MatthiasToberer/Hevo_STL_Archive/Bed_Brackets/Bed_Bracket_20_1.0.stl

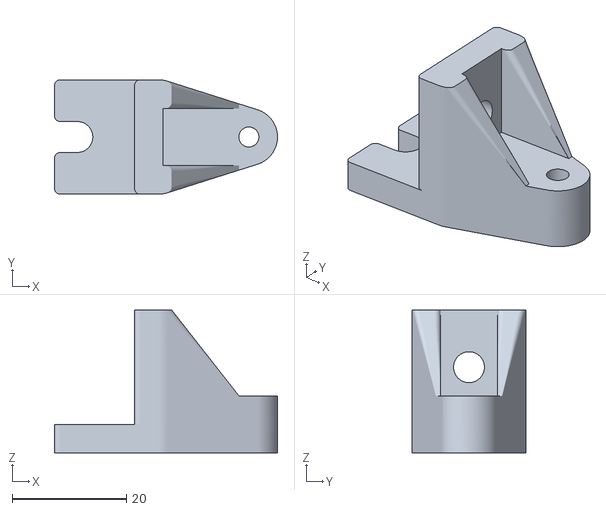
[picture p1: CAD file, 2019-02-11]
Bed_Brackets/Bed_Bracket_20_1.0.stl
39.0 x 20.0 x 25.0
