MatthiasToberer/Hevo_STL_Archive/Idler_Pulley/Idler-PULLEY_L_Y10_V2.0_European.stl

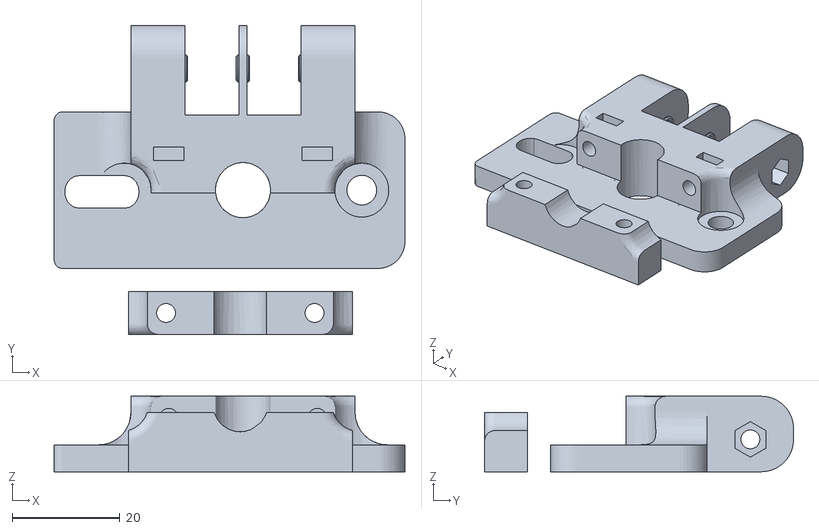
[picture p2: CAD file, 2019-02-11]
Idler_Pulley/Idler-PULLEY_L_Y10_V2.0_European.stl
65.0 x 57.2 x 14.0
