MatthiasToberer/Hevo_STL_Archive/Spindel/TR8x8_Support_BED.stl

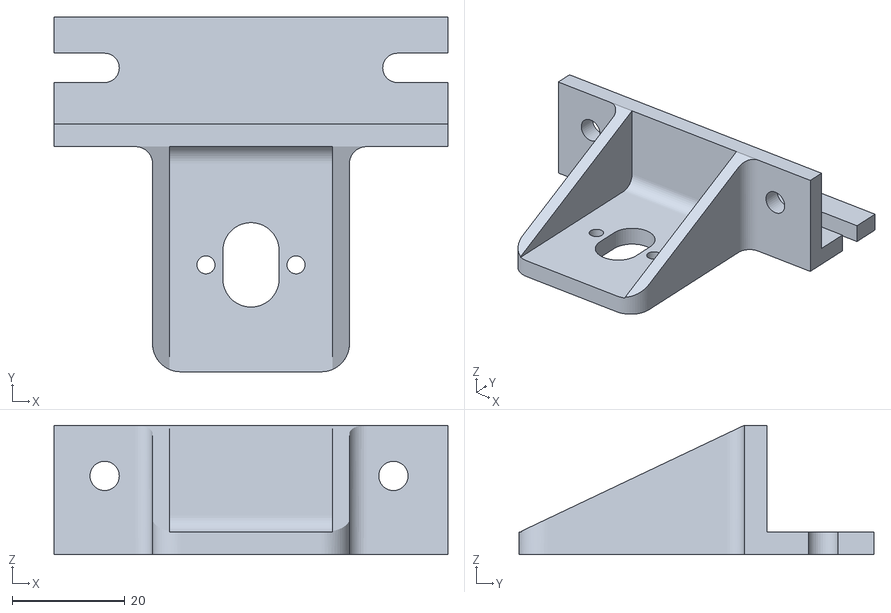
[picture p3: CAD file, 2019-02-11]
Spindel/TR8x8_Support_BED.stl
70.0 x 63.0 x 23.0
