MatthiasToberer/Hevo_STL_Archive/XY/XY_Carriage_Clamp_10mm_Bearing.stl

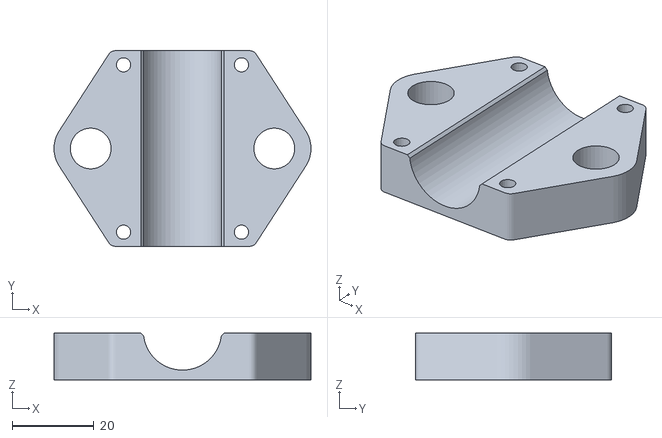
[picture p5: CAD file, 2019-02-11]
XY/XY_Carriage_Clamp_10mm_Bearing.stl
63.0 x 48.0 x 11.5
