MatthiasToberer/Hevo_STL_Archive/Bed_Brackets/Bed_Bracket_Variable_15-30.stl

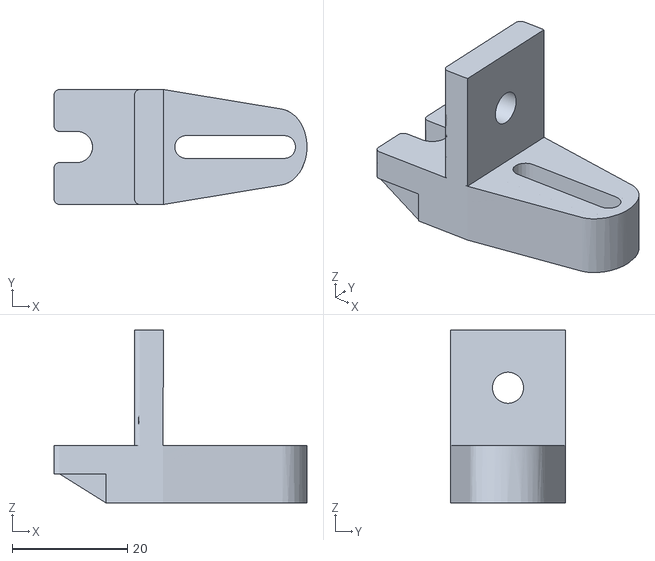
[picture p6: CAD file, 2019-02-11]
Bed_Brackets/Bed_Bracket_Variable_15-30.stl
44.0 x 20.0 x 30.0
