MatthiasToberer/Hevo_STL_Archive/Idler_Pulley/Idler-PULLEY_R_Y10_V2.0_European.stl

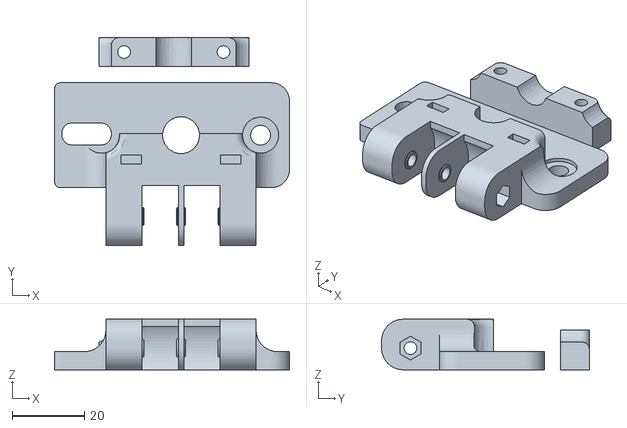
[picture p7: CAD file, 2019-02-11]
Idler_Pulley/Idler-PULLEY_R_Y10_V2.0_European.stl
65.0 x 57.5 x 14.0
