MatthiasToberer/Hevo_STL_Archive/Various_Parts/X_End_Stop_Flag_1.1.STL

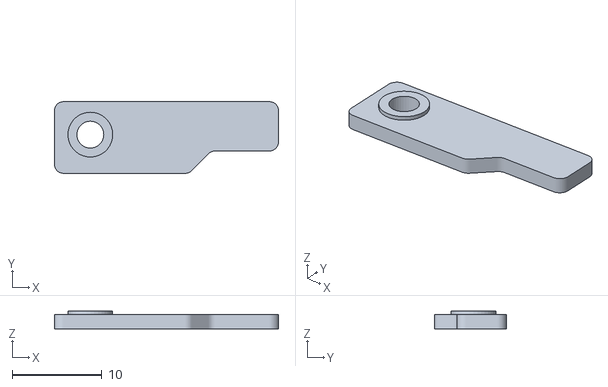
[picture p8: CAD file, 2019-02-11]
Various_Parts/X_End_Stop_Flag_1.1.STL
25.0 x 8.00 x 2.00
