MatthiasToberer/Hevo_STL_Archive/X_Carriage_Hotend/PP_Orion_Heatsink_Mount_Clamp_2.1.STL

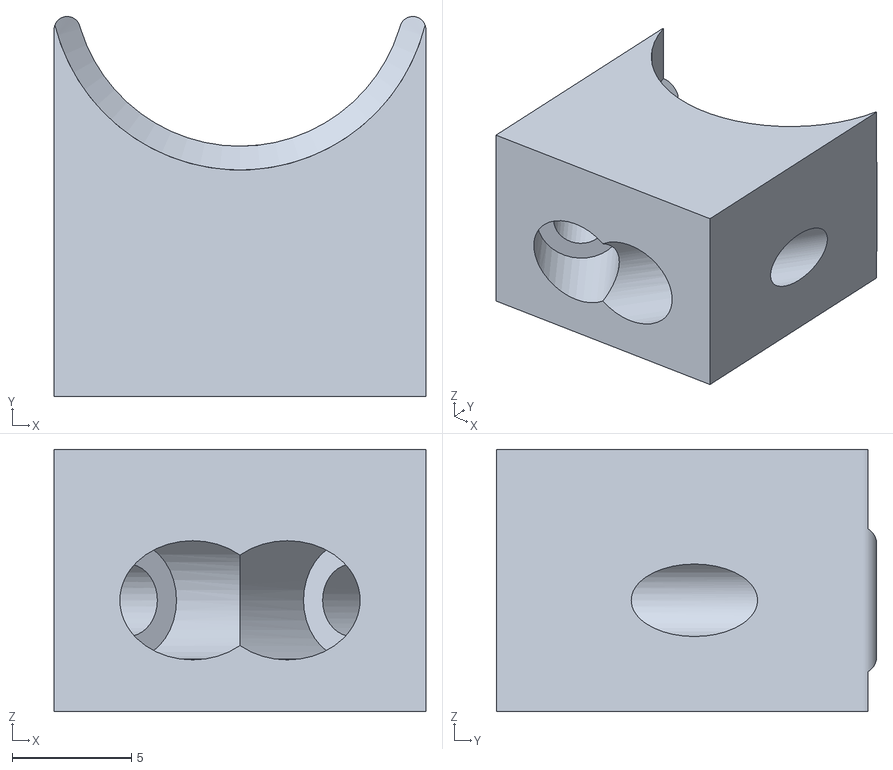
[picture p9: CAD file, 2019-02-11]
X_Carriage_Hotend/PP_Orion_Heatsink_Mount_Clamp_2.1.STL
15.6 x 15.9 x 11.0
