MatthiasToberer/Hevo_STL_Archive/XY/XY_Carriage_HCEvo_X10 Y10.stl

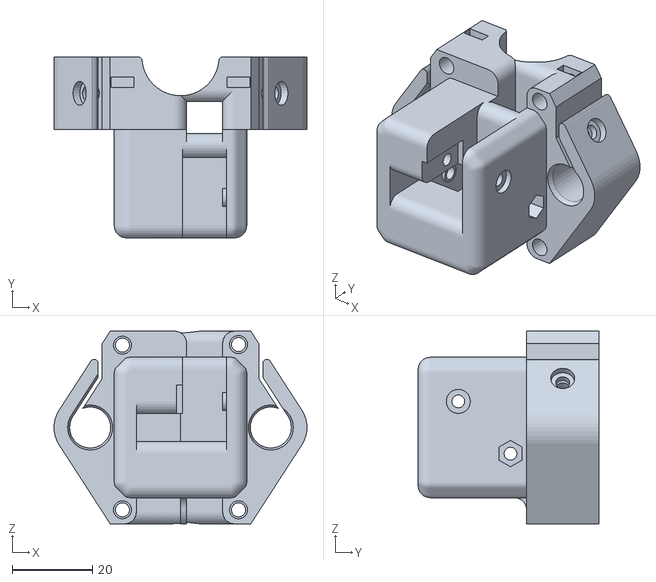
[picture p10: CAD file, 2019-02-11]
XY/XY_Carriage_HCEvo_X10 Y10.stl
63.0 x 45.0 x 48.0
