MatthiasToberer/Hevo_STL_Archive/Bed_Brackets/Bed_Bracket_25_1.0.stl

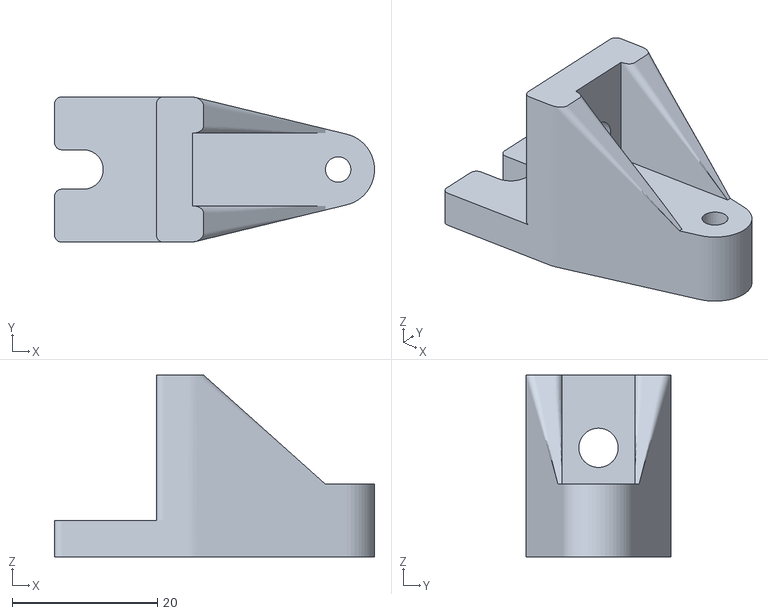
[picture p11: CAD file, 2019-02-11]
Bed_Brackets/Bed_Bracket_25_1.0.stl
44.0 x 20.0 x 25.0
