MatthiasToberer/Hevo_STL_Archive/Various_Parts/Y_endstop_flag_10mm.stl

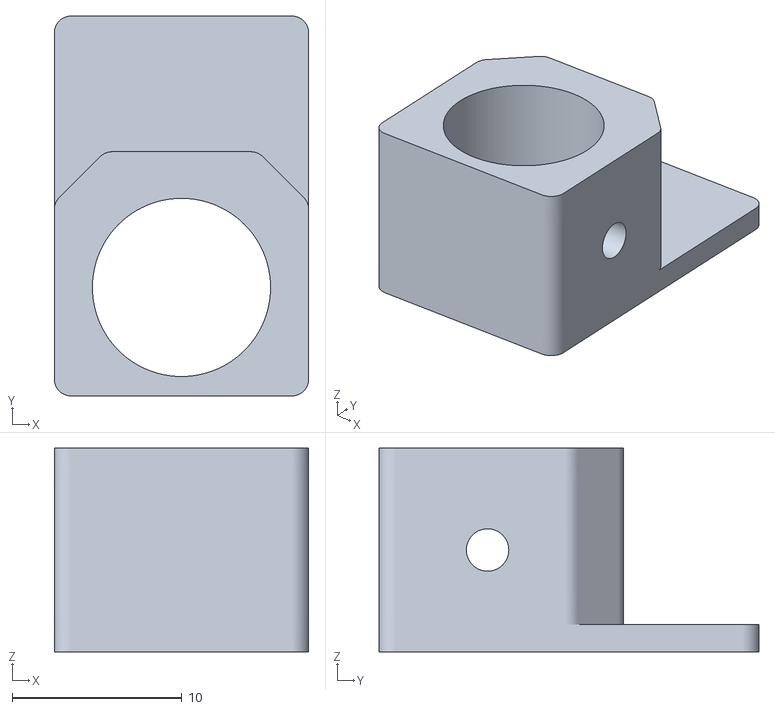
[picture p12: CAD file, 2019-02-11]
Various_Parts/Y_endstop_flag_10mm.stl
15.0 x 22.4 x 12.0
