MatthiasToberer/Hevo_STL_Archive/X_Carriage_Hotend/X_Carriage_2.1.STL

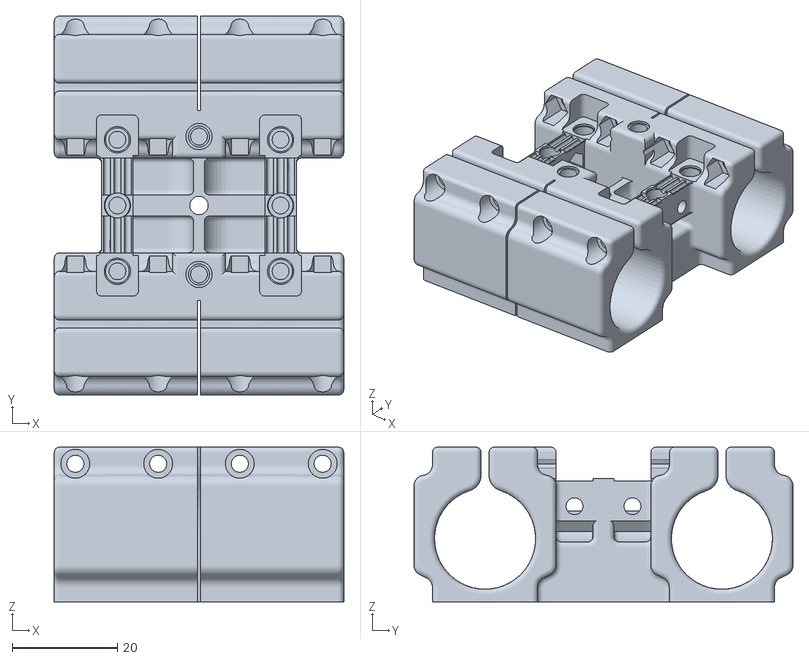
[picture p13: CAD file, 2019-02-11]
X_Carriage_Hotend/X_Carriage_2.1.STL
55.0 x 72.0 x 29.4
