MatthiasToberer/Hevo_STL_Archive/Various_Parts/Belt_Tensioner_1.0.stl

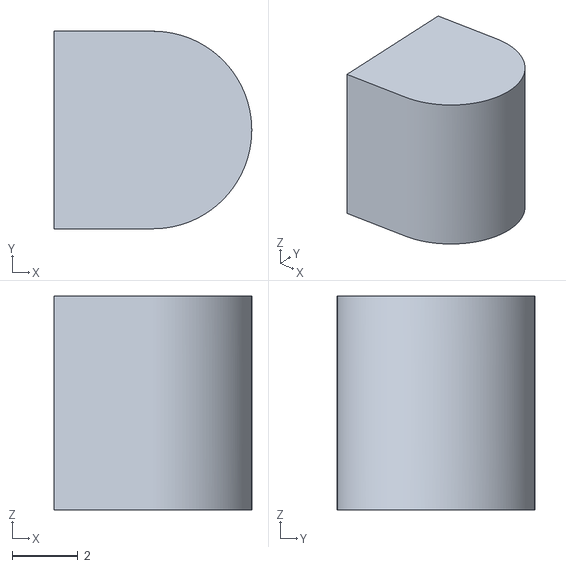
[picture p15: CAD file, 2019-02-11]
Various_Parts/Belt_Tensioner_1.0.stl
6.00 x 6.00 x 6.50
