MatthiasToberer/Hevo_STL_Archive/X_Carriage_Hotend/Duct_Diffuser_1.2.STL

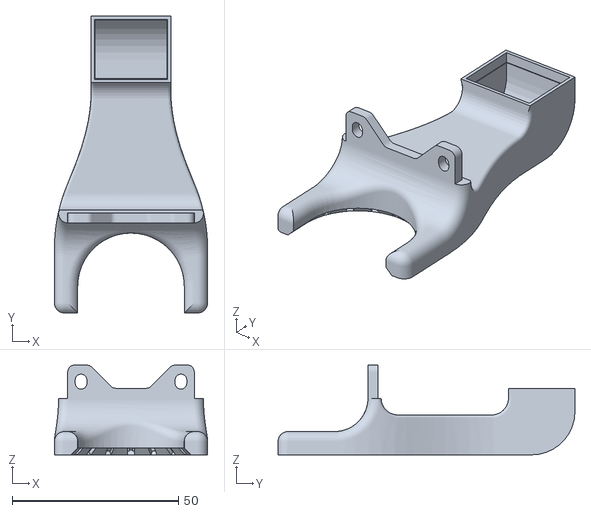
[picture p16: CAD file, 2019-02-11]
X_Carriage_Hotend/Duct_Diffuser_1.2.STL
46.0 x 89.2 x 27.0
