MatthiasToberer/Hevo_STL_Archive/Z/Z_STEPPER_MOUNT_NEMA_17_3030.stl

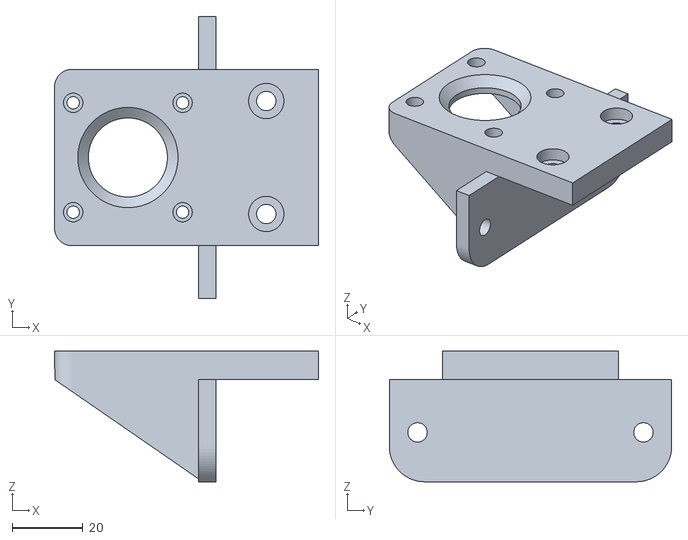
[picture p17: CAD file, 2019-02-11]
Z/Z_STEPPER_MOUNT_NEMA_17_3030.stl
74.8 x 80.0 x 37.0
