MatthiasToberer/Hevo_STL_Archive/Bed_Brackets/Bed_Bracket_Variable_30-45.STL

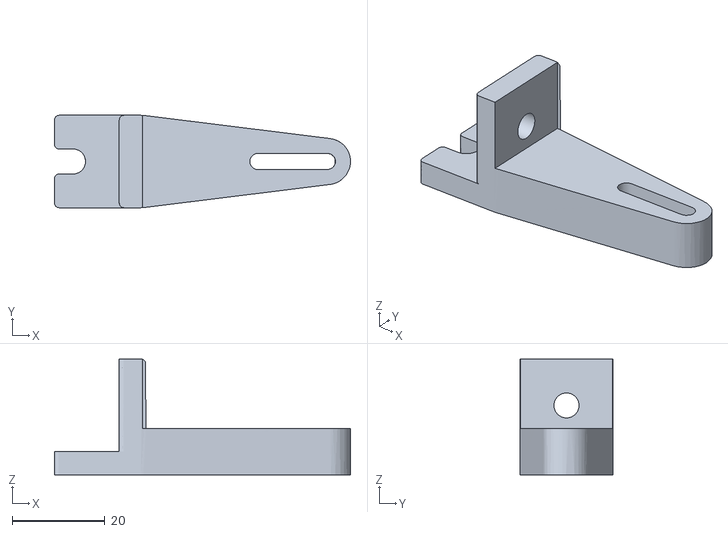
[picture p18: CAD file, 2019-02-11]
Bed_Brackets/Bed_Bracket_Variable_30-45.STL
64.0 x 20.0 x 25.0
