MatthiasToberer/Hevo_STL_Archive/X_Carriage_Hotend/BLTouch_Mount_1.1.STL

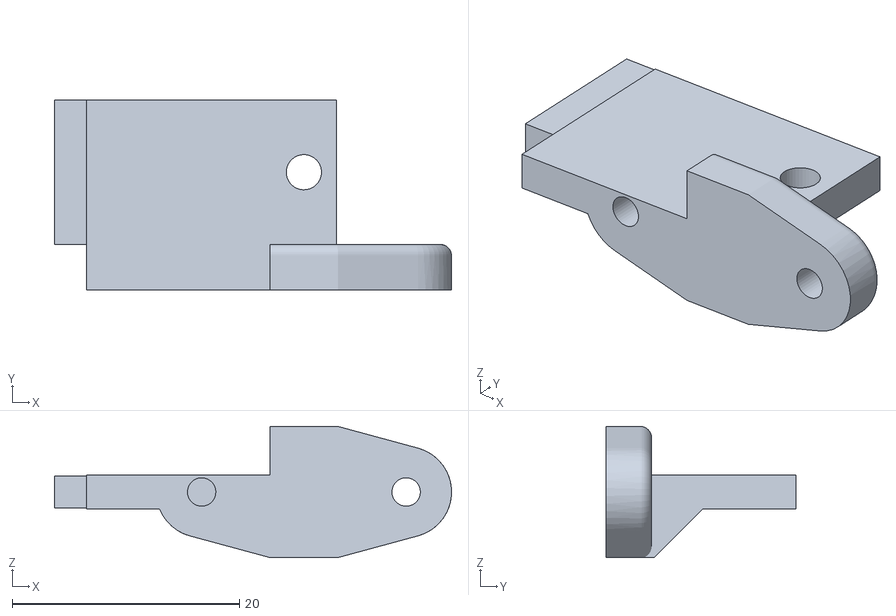
[picture p19: CAD file, 2019-02-11]
X_Carriage_Hotend/BLTouch_Mount_1.1.STL
34.9 x 16.7 x 11.5
