MatthiasToberer/Hevo_STL_Archive/Bed_Brackets/Bed_Bracket_45_1.0.stl

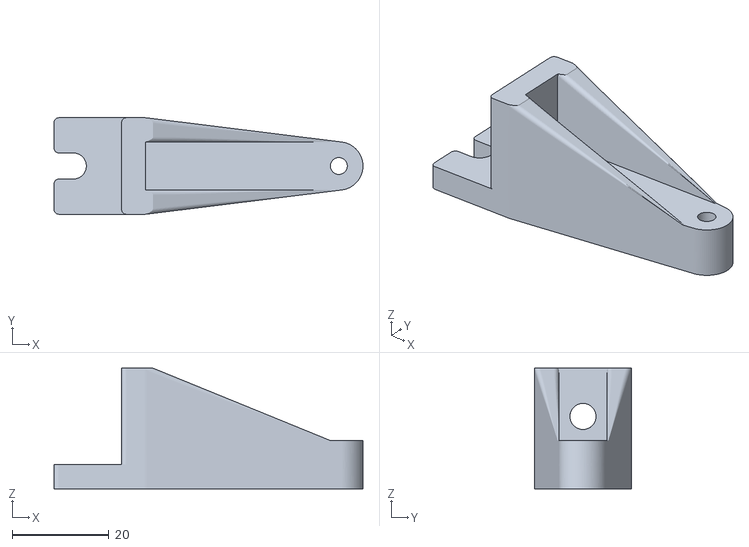
[picture p20: CAD file, 2019-02-11]
Bed_Brackets/Bed_Bracket_45_1.0.stl
64.0 x 20.0 x 25.0
