MatthiasToberer/Hevo_STL_Archive/Various_Parts/1204_Coupler-NEMA17.stl

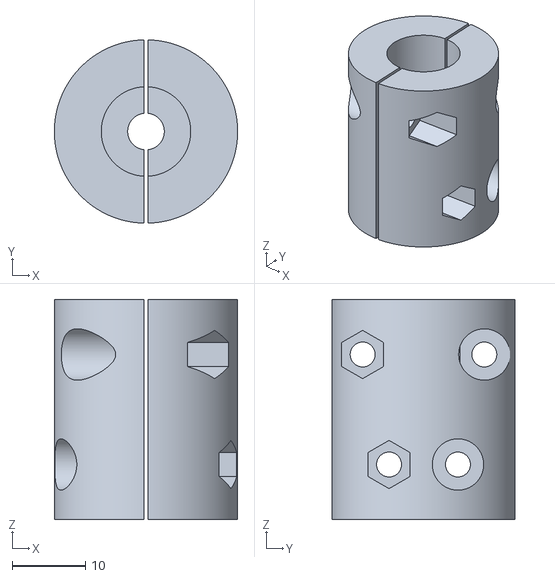
[picture p21: CAD file, 2019-02-11]
Various_Parts/1204_Coupler-NEMA17.stl
25.0 x 25.0 x 30.0
