MatthiasToberer/Hevo_STL_Archive/X_Carriage_Hotend/Extruder_Mount_3Conn_1.1.STL

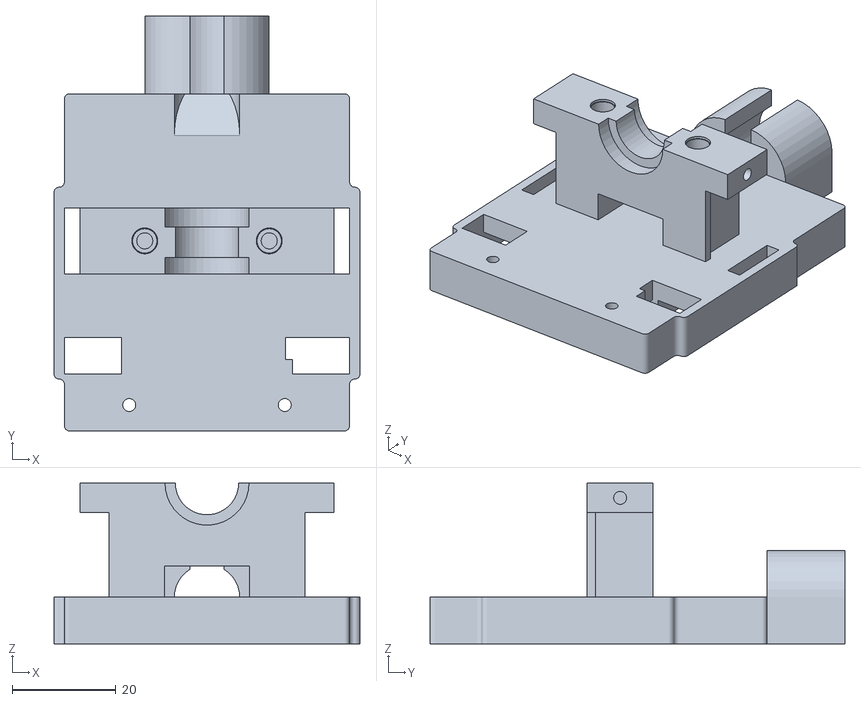
[picture p22: CAD file, 2019-02-11]
X_Carriage_Hotend/Extruder_Mount_3Conn_1.1.STL
59.0 x 80.0 x 31.0
