MatthiasToberer/Hevo_STL_Archive/Various_Parts/Z_Endstop_Bracket.stl

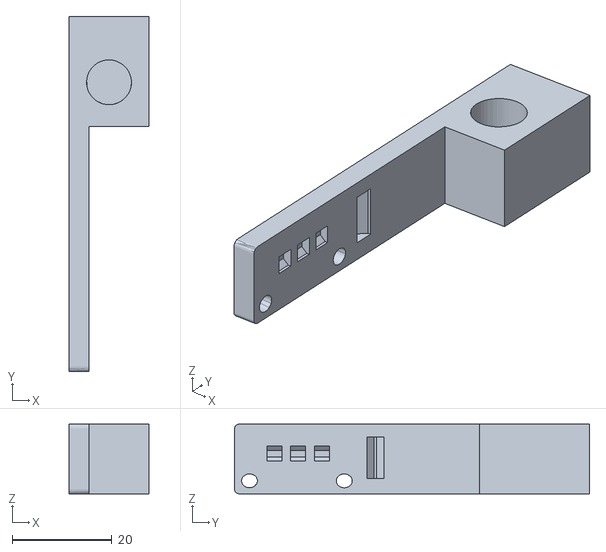
[picture p24: CAD file, 2019-02-11]
Various_Parts/Z_Endstop_Bracket.stl
16.0 x 71.1 x 14.0
