MatthiasToberer/Hevo_STL_Archive/X_Carriage_Hotend/PP_Hotend_Clamp_1.0.STL

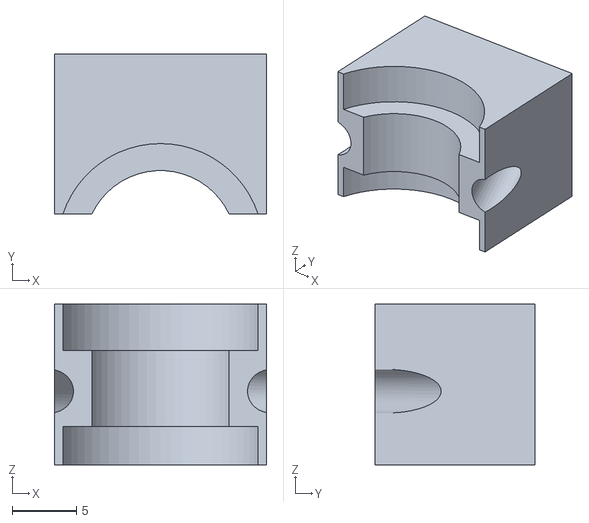
[picture p25: CAD file, 2019-02-11]
X_Carriage_Hotend/PP_Hotend_Clamp_1.0.STL
16.5 x 12.5 x 12.5
