MatthiasToberer/Hevo_STL_Archive/Various_Parts/T_Slot_Cover_1.0_-_250mm.stl

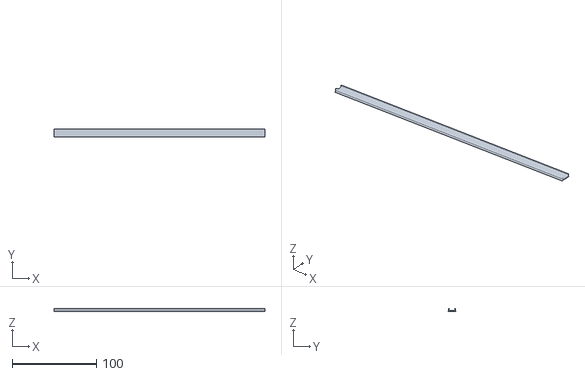
[picture p27: CAD file, 2019-02-11]
Various_Parts/T_Slot_Cover_1.0_-_250mm.stl
250.0 x 9.80 x 3.20
