MatthiasToberer/Hevo_STL_Archive/X_Carriage_Hotend/Fan_Mount_1.1.STL

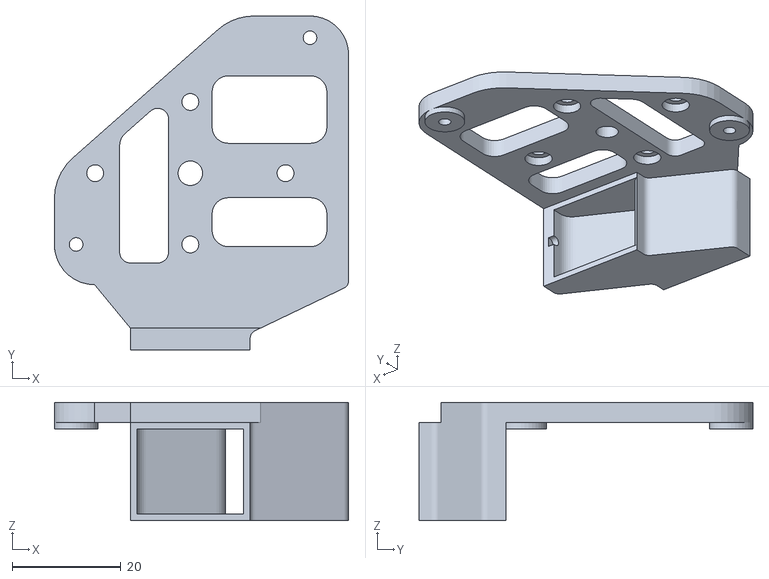
[picture p28: CAD file, 2019-02-11]
X_Carriage_Hotend/Fan_Mount_1.1.STL
54.1 x 61.4 x 21.7
