MatthiasToberer/Hevo_STL_Archive/Various_Parts/3030_MK8_Extruder_Holder.stl

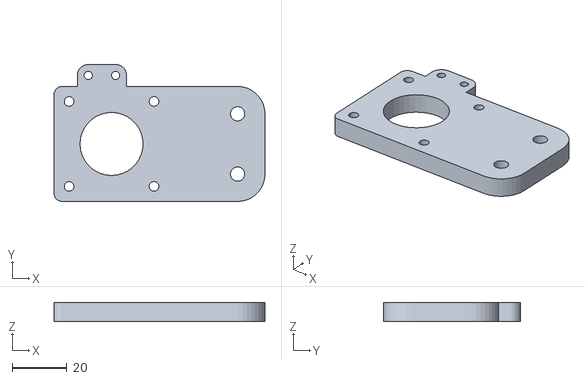
[picture p29: CAD file, 2019-02-11]
Various_Parts/3030_MK8_Extruder_Holder.stl
77.0 x 50.0 x 7.00
