MatthiasToberer/Hevo_STL_Archive/X_Carriage_Hotend/Duct_Diffuser_2.1.STL

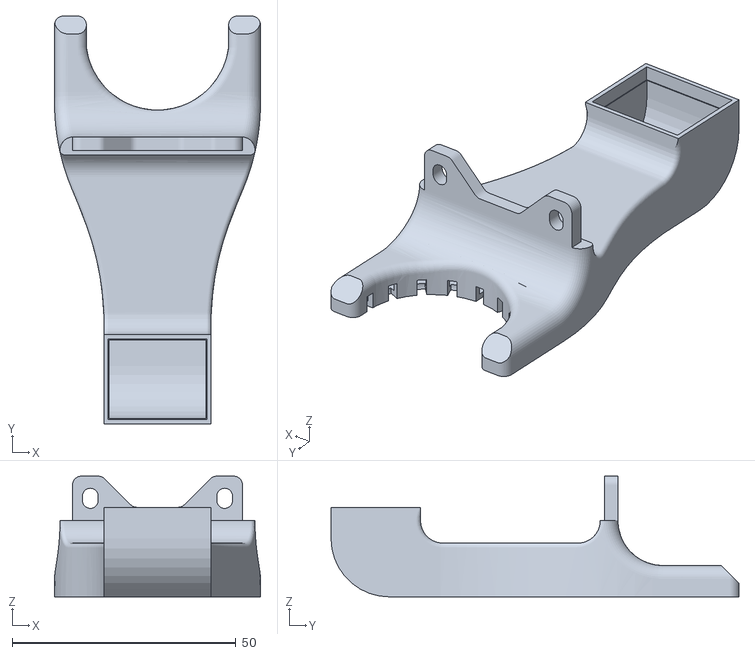
[picture p30: CAD file, 2019-02-11]
X_Carriage_Hotend/Duct_Diffuser_2.1.STL
46.0 x 91.1 x 27.0
