MatthiasToberer/Hevo_STL_Archive/Various_Parts/Y_End_Stop_Bracket_1.0.stl

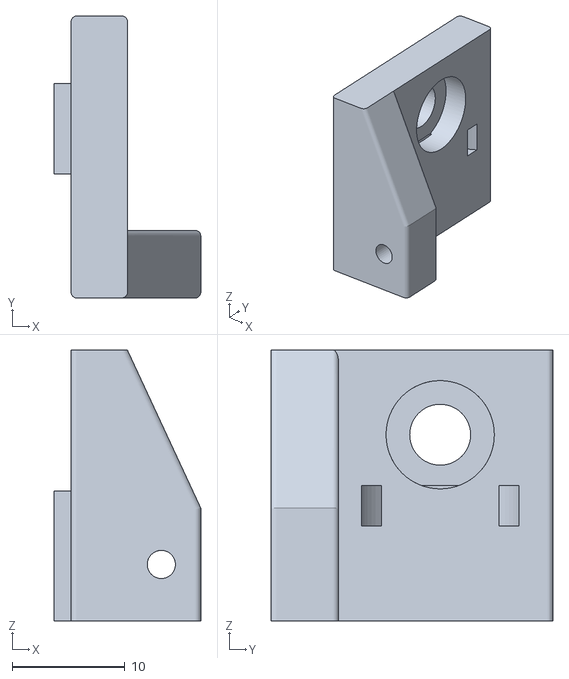
[picture p31: CAD file, 2019-02-11]
Various_Parts/Y_End_Stop_Bracket_1.0.stl
13.0 x 25.0 x 24.0
