MatthiasToberer/Hevo_STL_Archive/X_Carriage_Hotend/PP_Orion_Heatsink_Fan_Duct_1.1.STL

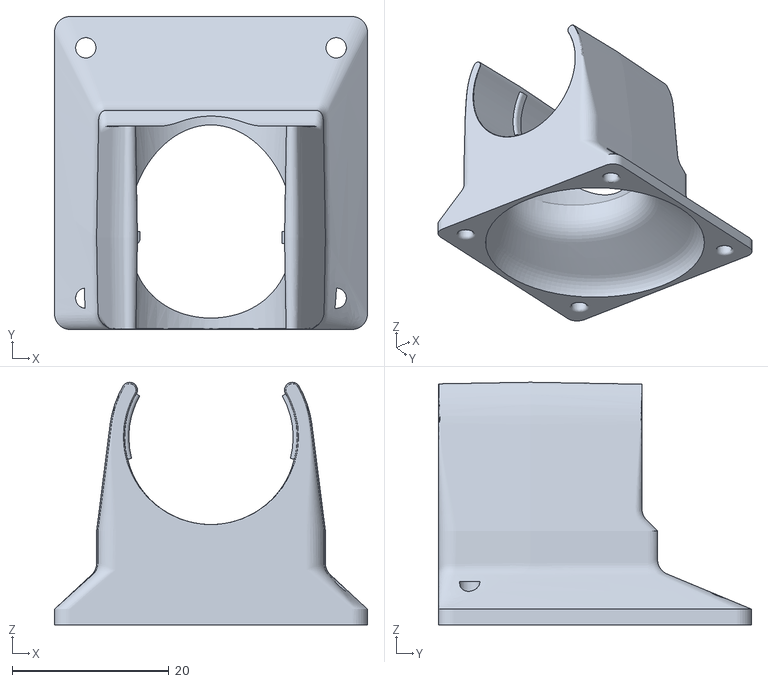
[picture p32: CAD file, 2019-02-11]
X_Carriage_Hotend/PP_Orion_Heatsink_Fan_Duct_1.1.STL
40.0 x 40.0 x 31.0
