MatthiasToberer/Hevo_STL_Archive/X_Carriage_Hotend/PP_Electrical_Cover_Rt_1.1.STL

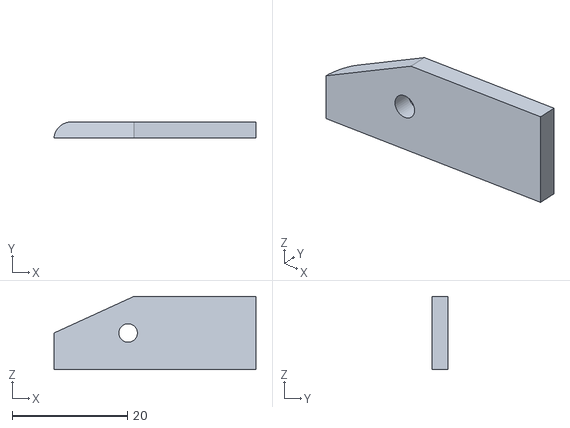
[picture p33: CAD file, 2019-02-11]
X_Carriage_Hotend/PP_Electrical_Cover_Rt_1.1.STL
35.0 x 2.80 x 12.7
