MatthiasToberer/Hevo_STL_Archive/X_Carriage_Hotend/Duct_Diffusor_remix.stl

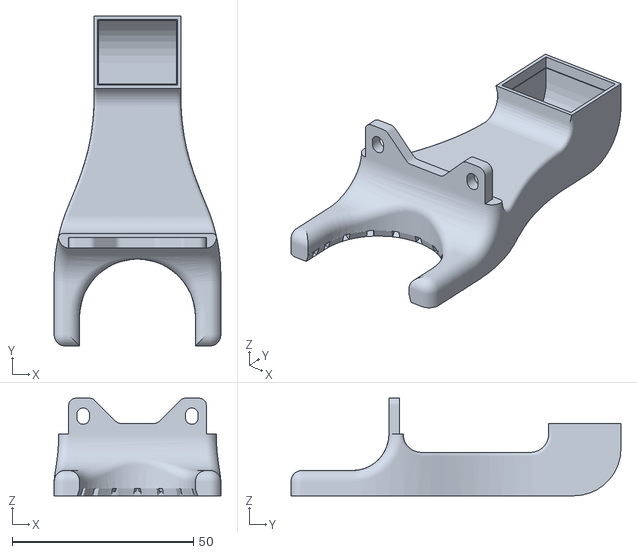
[picture p34: CAD file, 2019-02-11]
X_Carriage_Hotend/Duct_Diffusor_remix.stl
46.0 x 91.1 x 26.9
