MatthiasToberer/Hevo_STL_Archive/X_Carriage_Hotend/Duct_360_Diffuser_Volcano_1.1.STL

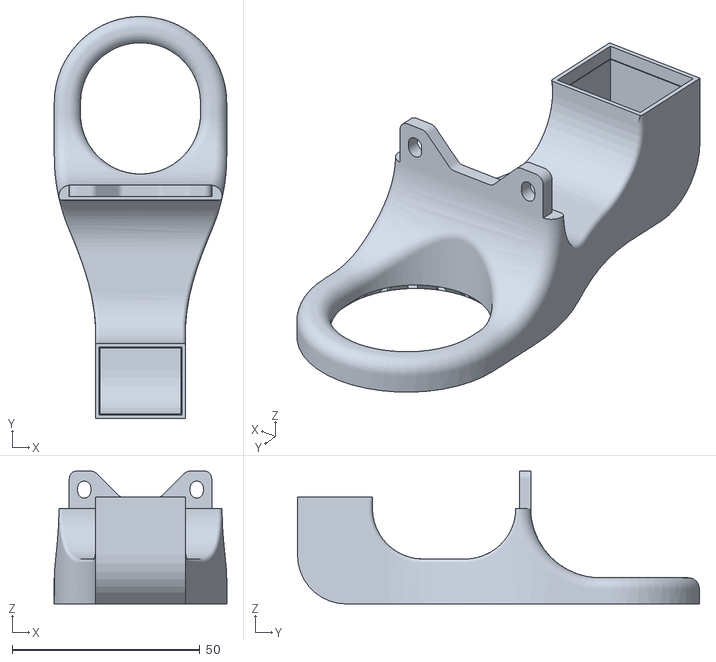
[picture p35: CAD file, 2019-02-11]
X_Carriage_Hotend/Duct_360_Diffuser_Volcano_1.1.STL
46.0 x 107.2 x 35.5
