MatthiasToberer/Hevo_STL_Archive/X_Carriage_Hotend/X_Carriage_Clamp_2.1.STL

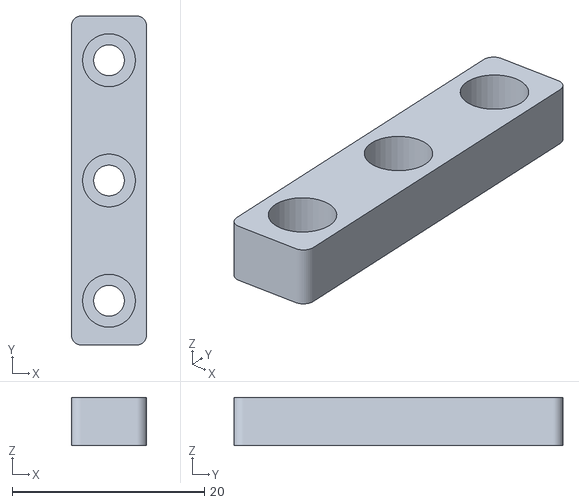
[picture p36: CAD file, 2019-02-11]
X_Carriage_Hotend/X_Carriage_Clamp_2.1.STL
7.80 x 34.2 x 5.00
