MatthiasToberer/Hevo_STL_Archive/X_Carriage_Hotend/PP_-_Z_Nimble_Extruder_Mount_1.0.STL

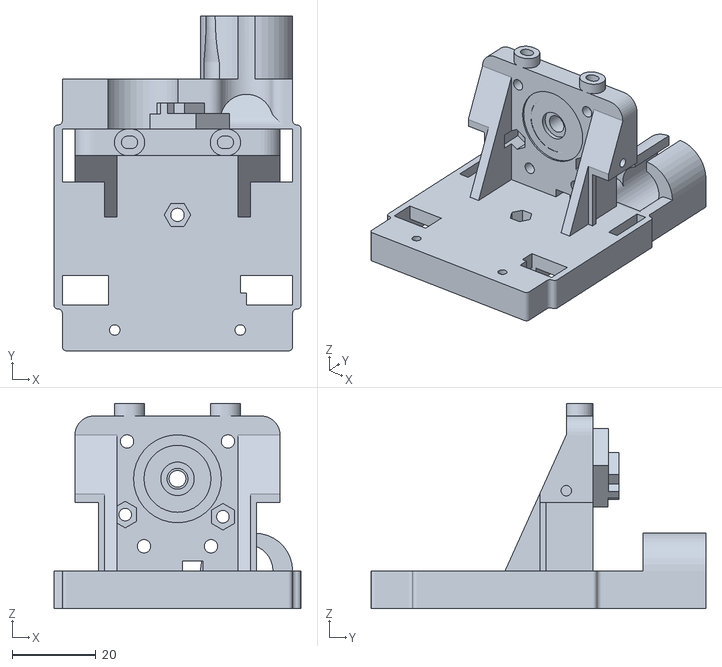
[picture p37: CAD file, 2019-02-11]
X_Carriage_Hotend/PP_-_Z_Nimble_Extruder_Mount_1.0.STL
59.0 x 80.0 x 49.0
