MatthiasToberer/Hevo_STL_Archive/X_Carriage_Hotend/Extruder_Mount_Z_Nimble_1.1.STL

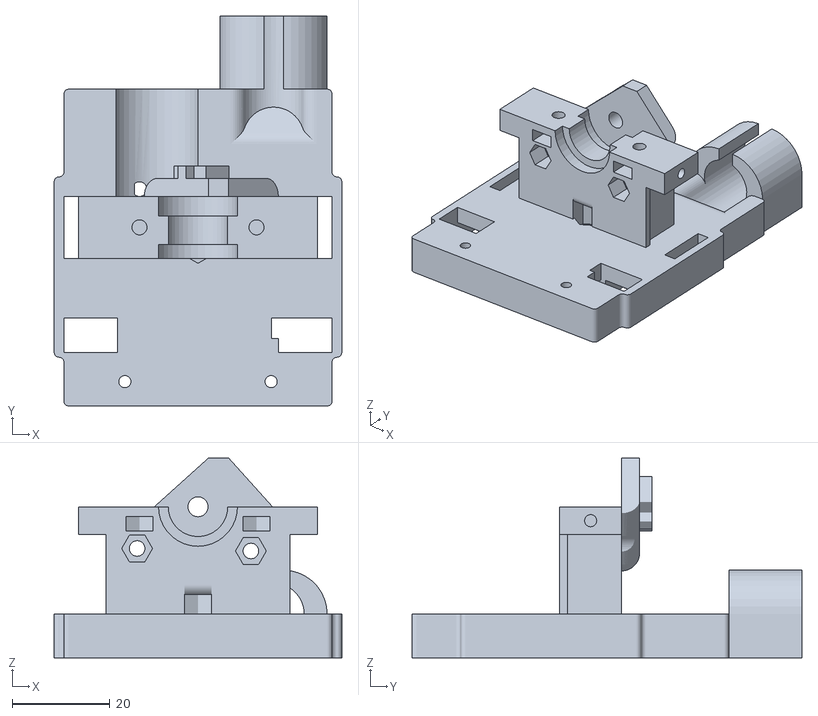
[picture p38: CAD file, 2019-02-11]
X_Carriage_Hotend/Extruder_Mount_Z_Nimble_1.1.STL
59.0 x 80.0 x 41.0
