MatthiasToberer/Hevo_STL_Archive/X_Carriage_Hotend/Fan_Mount_Probe_1.1.STL

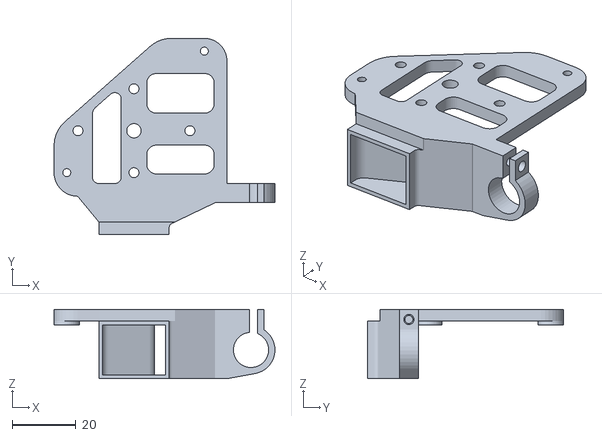
[picture p42: CAD file, 2019-02-11]
X_Carriage_Hotend/Fan_Mount_Probe_1.1.STL
69.1 x 61.4 x 21.7
