MatthiasToberer/Hevo_STL_Archive/X_Carriage_Hotend/PP_-_Z_Nimble_Heatsink_Mount_PC4_1.0.STL

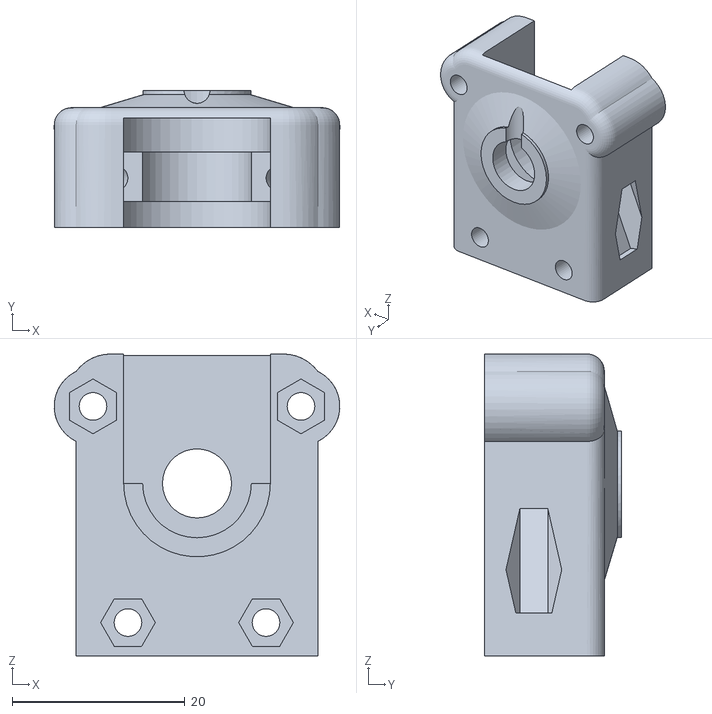
[picture p45: CAD file, 2019-02-11]
X_Carriage_Hotend/PP_-_Z_Nimble_Heatsink_Mount_PC4_1.0.STL
33.1 x 15.9 x 35.0
