MatthiasToberer/Hevo_STL_Archive/X_Carriage_Hotend/Duct_360_Diffuser_2.1.STL

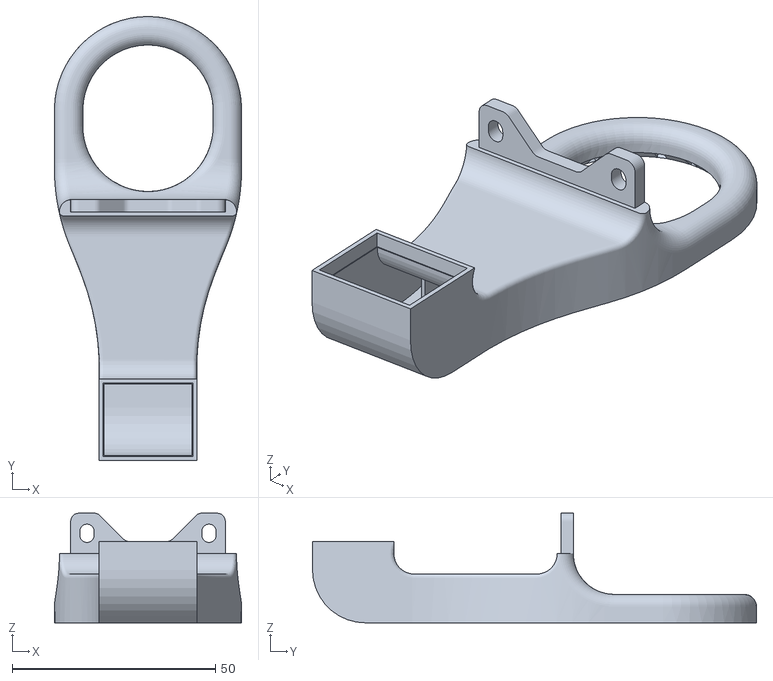
[picture p46: CAD file, 2019-02-11]
X_Carriage_Hotend/Duct_360_Diffuser_2.1.STL
46.0 x 109.1 x 27.0
