MatthiasToberer/Hevo_STL_Archive/X_Carriage_Hotend/Extruder_Mount_Clamp_1.1.STL

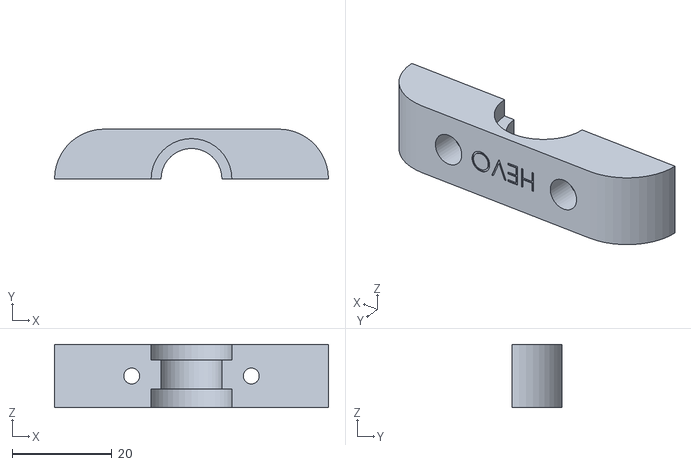
[picture p47: CAD file, 2019-02-11]
X_Carriage_Hotend/Extruder_Mount_Clamp_1.1.STL
55.0 x 10.0 x 12.7
