MatthiasToberer/Hevo_STL_Archive/X_Carriage_Hotend/PP_Universal_Extruder_Mount_PC4_1.2.STL

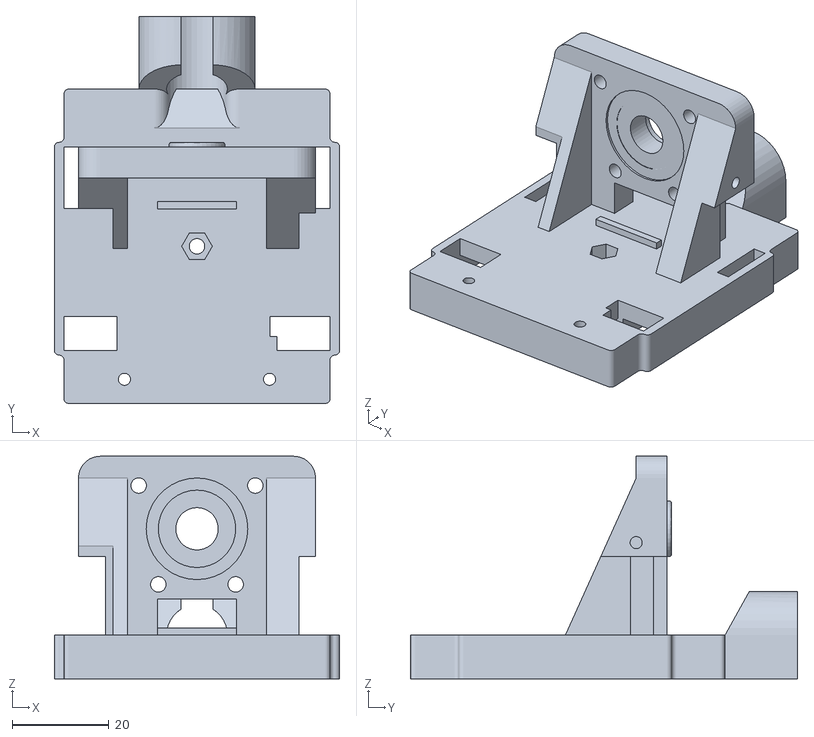
[picture p48: CAD file, 2019-02-11]
X_Carriage_Hotend/PP_Universal_Extruder_Mount_PC4_1.2.STL
59.0 x 80.0 x 46.0
