MatthiasToberer/Hevo_STL_Archive/X_Carriage_Hotend/PP_Heatsink_Mount_Embedded_Bowden_1.2.STL

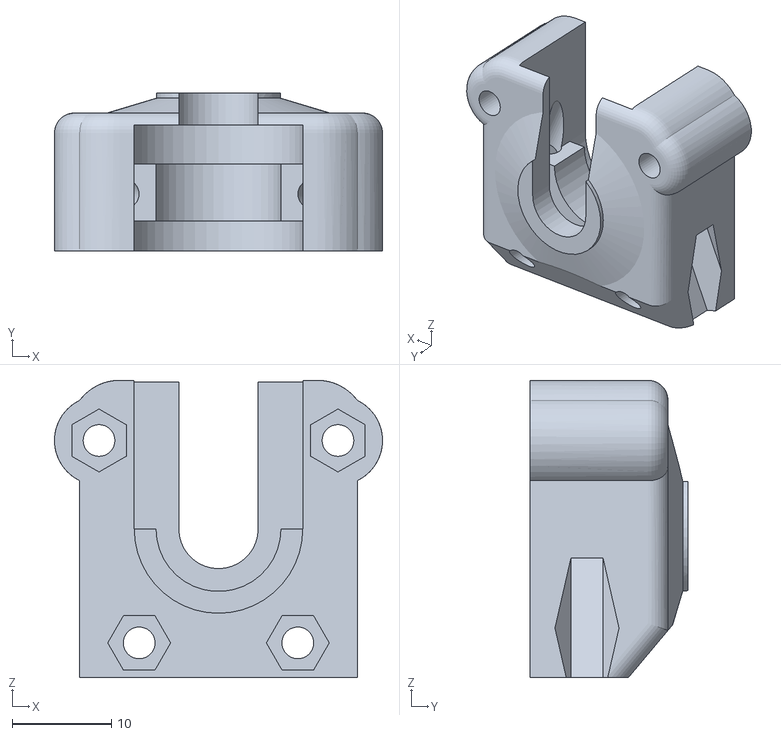
[picture p49: CAD file, 2019-02-11]
X_Carriage_Hotend/PP_Heatsink_Mount_Embedded_Bowden_1.2.STL
33.1 x 15.9 x 30.0
