MatthiasToberer/Hevo_STL_Archive/X_Carriage_Hotend/PP_Orion_Heatsink_Mount_Clamp_2.2.STL

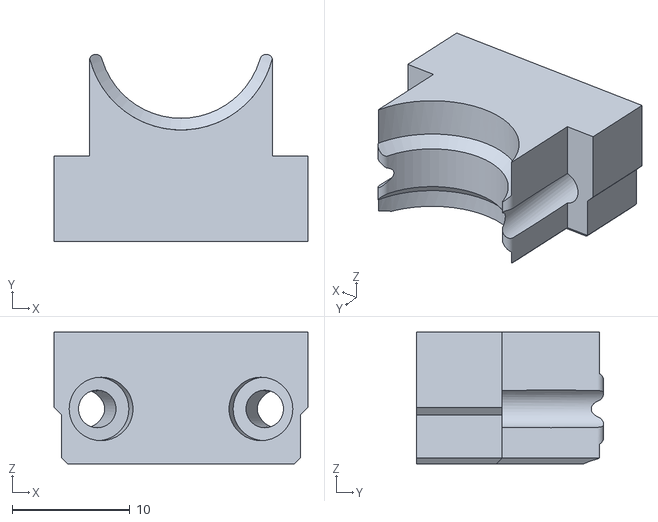
[picture p50: CAD file, 2019-02-11]
X_Carriage_Hotend/PP_Orion_Heatsink_Mount_Clamp_2.2.STL
21.6 x 15.9 x 11.2
