MatthiasToberer/Hevo_STL_Archive/X_Carriage_Hotend/PP_Orion_Extruder_Mount_Zesty_Nimble_1.1.STL

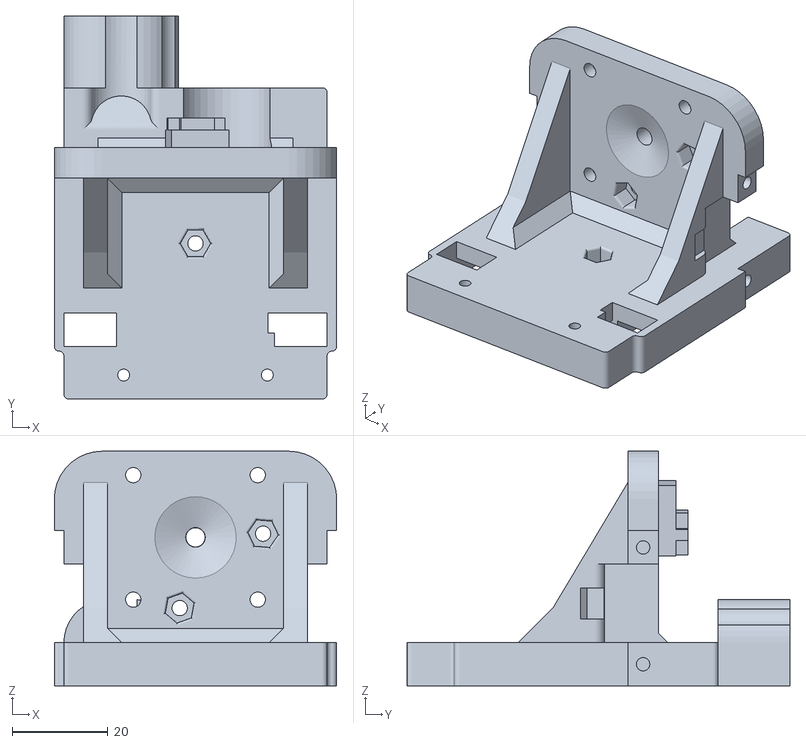
[picture p51: CAD file, 2019-02-11]
X_Carriage_Hotend/PP_Orion_Extruder_Mount_Zesty_Nimble_1.1.STL
59.0 x 80.0 x 49.0
