MatthiasToberer/Hevo_STL_Archive/X_Carriage_Hotend/PP_Orion_Electrical_Cover_1.1.STL

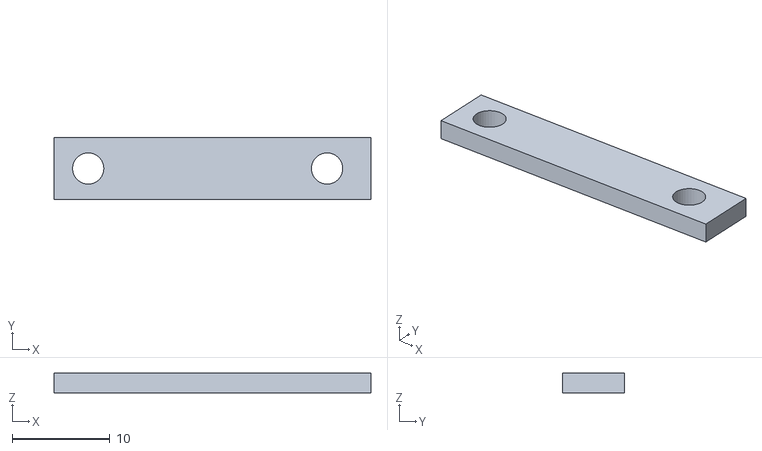
[picture p52: CAD file, 2019-02-11]
X_Carriage_Hotend/PP_Orion_Electrical_Cover_1.1.STL
32.5 x 6.30 x 2.00
