MatthiasToberer/Hevo_STL_Archive/X_Carriage_Hotend/X_Carriage_1.1.STL

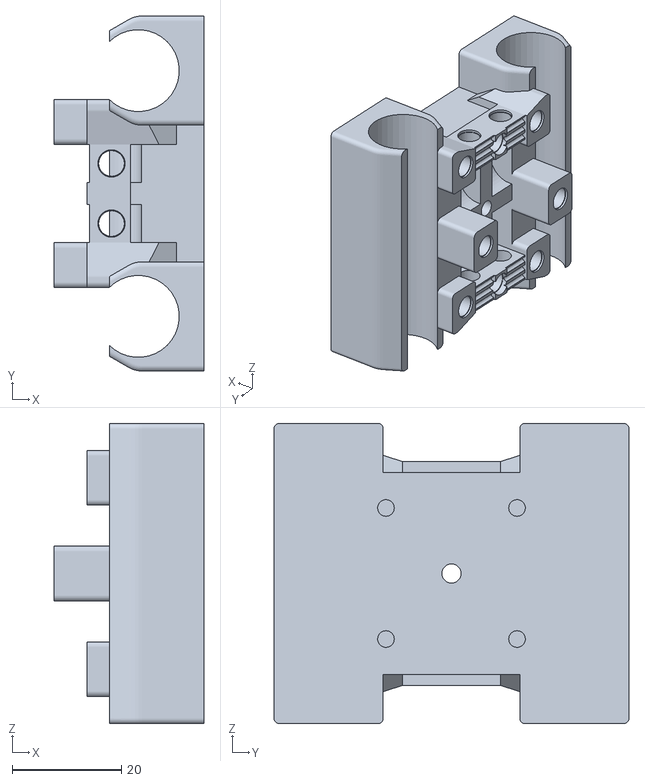
[picture p54: CAD file, 2019-02-11]
X_Carriage_Hotend/X_Carriage_1.1.STL
27.4 x 65.0 x 55.0
