MatthiasToberer/Hevo_STL_Archive/X_Carriage_Hotend/PP_Orion_Heatsink_Mount_1.1.STL

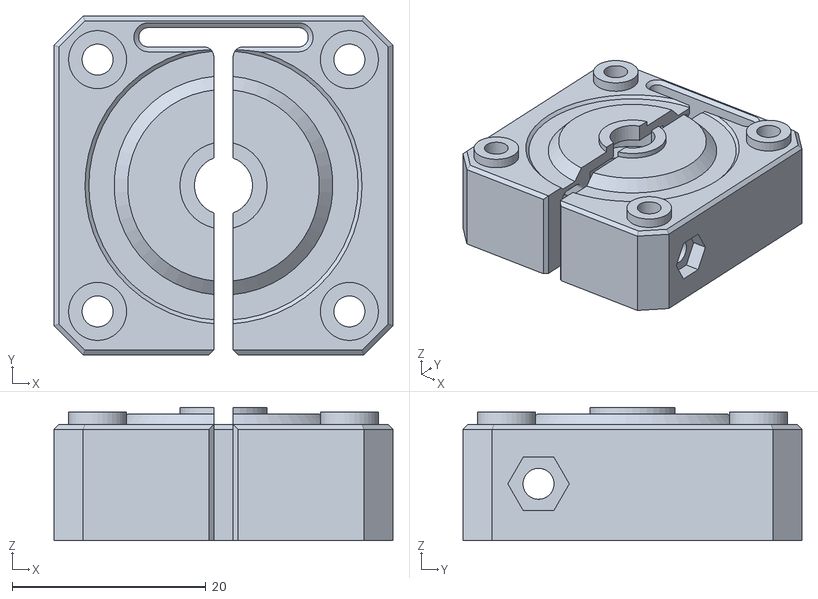
[picture p55: CAD file, 2019-02-11]
X_Carriage_Hotend/PP_Orion_Heatsink_Mount_1.1.STL
35.0 x 35.0 x 13.8
