MatthiasToberer/Hevo_STL_Archive/X_Carriage_Hotend/PP_-_Z_Nimble_Sidewinder_Extruder_Mount_1.0.STL

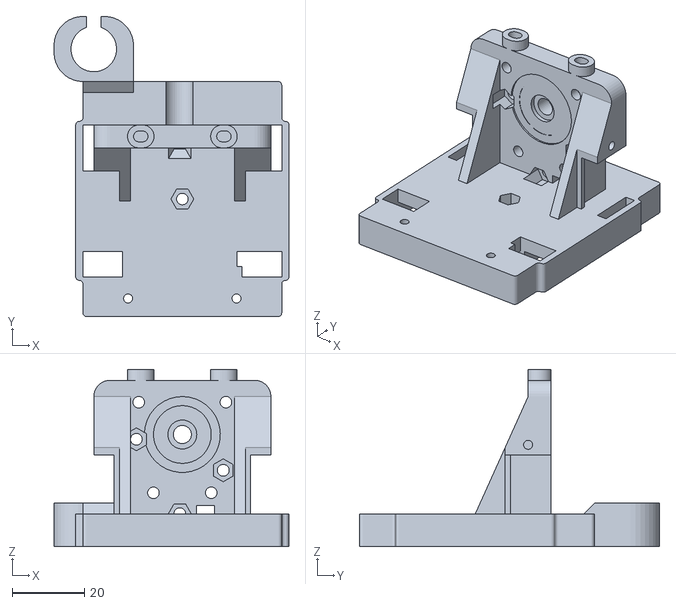
[picture p56: CAD file, 2019-02-11]
X_Carriage_Hotend/PP_-_Z_Nimble_Sidewinder_Extruder_Mount_1.0.STL
65.0 x 83.0 x 49.0
