MatthiasToberer/Hevo_STL_Archive/X_Carriage_Hotend/PP_Orion_Heatsink_Mount_2.2.STL

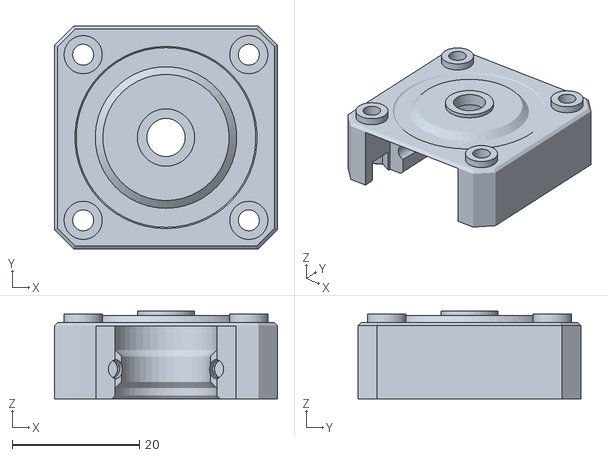
[picture p58: CAD file, 2019-02-11]
X_Carriage_Hotend/PP_Orion_Heatsink_Mount_2.2.STL
35.0 x 35.0 x 13.8
