MatthiasToberer/Hevo_STL_Archive/X_Carriage_Hotend/Extruder_Mount_Conn_Cover_1.1.STL

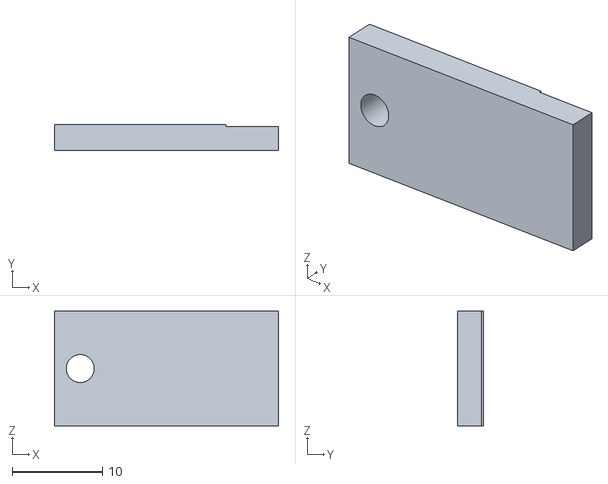
[picture p61: CAD file, 2019-02-11]
X_Carriage_Hotend/Extruder_Mount_Conn_Cover_1.1.STL
24.8 x 2.90 x 12.7
