MatthiasToberer/Hevo_STL_Archive/(list of files, cad)

Other CAD files:
XY/XY_Carriage_HCEvo_X8 Y10.stl
Various_Parts/Y_End_Stop_Flag_1.0.stl
X_Carriage_Hotend/PP_Orion_Extruder_Mount_Embedded_Bowden_1.1.STL
X_Carriage_Hotend/Extruder_Mount_2Conn_1.1.STL
X_Carriage_Hotend/X_Carriage_2.1.1.STL
X_Carriage_Hotend/Duct_360_Diffuser_Volcano_2.1.STL
X_Carriage_Hotend/Duct_Nozzle_2.1.STL
X_Carriage_Hotend/Duct_360_Diffuser_1.1.STL
X_Carriage_Hotend/PP_Orion_Extruder_Mount_PC4_1.1.STL
X_Carriage_Hotend/Duct_Nozzle_1.1.STL
X_Carriage_Hotend/X_Carriage_2.1.3.STL
X_Carriage_Hotend/PP_Extruder_Mount_Embedded_Bowden_1.2.STL
X_Carriage_Hotend/Extruder_Mount_Clamp_Z_Nimble_1.1.STL
X_Carriage_Hotend/X_Carriage_2.1.2.STL
X_Carriage_Hotend/PP_Universal_Extruder_Mount_Embedded_Bowden_1.2.STL
X_Carriage_Hotend/Duct_Diffuser_2.2.STL
Various_Parts/1204_Z-Screw-Bracket_V2.stl
Various_Parts/Z_Endstop_Screwholder.stl
Z/Z-Axis_MISUMI_LM12LUU_Bearing_Holder.stl
Z/Z_BRAKET_DOWN_L_3mm_NUT.stl
Z/Z_BRAKET_DOWN_R_3mm_NUT.stl
Z/Z_BRAKET_L_3mm_NUT.stl
Z/Z_BRAKET_R_3mm_NUT.stl
